dobneyresearch/PCNchip_with_leakyjug_learning/paper/main_stage2_v4.tex

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

\newcommand{\W}{\bm W}
\newcommand{\x}{\bm x}
\newcommand{\bdelta}{\bm\delta}
\newcommand{\E}{\bm E}

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

\hypertarget{sec:intro}{%
\section{Introduction}\label{sec:intro}}

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

This barrier is not unique to predictive coding; it is the central
difficulty of the whole analog-learning field, approached from several
directions. Analog in-memory training on non-volatile memory has reached
digital-equivalent accuracy \cite{ambrogio2018equivalent}, but it runs
conventional backpropagation --- transposed backward pass included ---
and depends on device-level symmetry of the weight update. Mixed-signal
spiking neural networks (SNNs) take the opposite premise: following the
biological observation that neurons \emph{integrate inputs as an analog
sum but communicate with spikes} \cite{cramer2022surrogate}, they
compute in analog and route events on an asynchronous digital fabric
\cite{chicca2014neuromorphic, benjamin2014neurogrid, moradi2018dynap}.
Their unsolved problem is training: device mismatch and low precision
distort weights and activations, so competitive accuracy is obtained
either by per-neuron calibration or by training the substrate \emph{in
the loop} with a host --- for example surrogate-gradient descent on
BrainScaleS-2, where ``learning self-corrects for device mismatch''
\cite{cramer2022surrogate}. On-chip local rules that avoid the host
\cite{rubino2023neuromorphic, davies2018loihi} remain Hebbian or
spike-timing based and do not reach backpropagation-grade credit
assignment on deep tasks. The common thread is that making a mismatched
analog substrate learn well has, so far, required either calibration, a
backward pass, or a host in the training loop.

Within predictive coding proper, Whittington and Bogacz
\cite{whittington2017approximation} establish the relationship to
backpropagation that motivates the approach, and Millidge et al.
\cite{millidge2022predictive} survey subsequent variants; recent work
has also reported synthesisable RTL realisations of PC networks
\cite{oh2026synthesizable}. What has been missing is an analog PC
design that trains in place \emph{without} reintroducing the backward
pass, the host, or the calibration step. This paper reports such an
architecture, together with its validation. We adopt three constraints
as design invariants rather than objectives, and do not relax them:

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

\begin{itemize}
\item
  An architecture in which the chip is an autonomous predictive-coding
  \emph{level}: it holds one copy of its weights \(\bm W\) and reads
  that copy three ways --- forward prediction, transpose relay, and
  error accumulation --- so that no weight ever leaves the die and every
  weight update is a local transaction (Sec. 3).
\item
  \emph{Transpose-at-source}: computing \(\bm W^{\!\top}\bm\delta\) on
  the chip that owns \(\bm W\), which eliminates the remote weight copy
  together with its coherence traffic and its synchronisation barrier,
  and reduces the router to summation and division (Secs. 3, 5).
\item
  A sigma--delta weight update in the error store \(\bm E\) (the
  \emph{leaky jug}), realised as a leaking capacitor and a shared
  comparator. The modulator is a standard structure; the contribution is
  its use as the weight-update path and the training-specific
  consequences of its bounded quantisation error --- why a learning rate
  of \(0.019\) weight LSB can drive an 8-bit analog cell with no
  per-synapse digital accumulator, why the comparator's decisions may be
  wrong at a substantial rate without corrupting learning, and why
  device mismatch acts only as a benign per-synapse learning-rate spread
  (Secs. 4, 6).
\item
  Validation on EMNIST letters showing the forwards-only rule matches
  backpropagation on the same topology, survives a bit-faithful hardware
  model and hostile device mismatch, with reported negative results
  (Secs. 6, 7), and an explicit positioning against NVM-based and
  spiking analog designs (Sec. 8).
\end{itemize}

\hypertarget{sec:pc}{%
\section{Predictive coding and the analog-neuromorphic
context}\label{sec:pc}}

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

Predictive coding models perception as inference in a hierarchical
generative model: each level emits a prediction of the level below and
retains the discrepancy as an error, and both representations and
weights are adjusted to reduce it
\cite{rao1999predictive, bogacz2017tutorial}. Its defining structural
commitment, and the one we build on, is that representation and error
are carried by \emph{separate} populations interacting only locally, one
level apart. We refer to this as the \(\bm W\&\bm E\) organisation:
activations are propagated forward through the weights \(\bm W\), errors
are accumulated in a separate store \(\bm E\), and when \(\bm E\)
crosses a threshold the corresponding weight in \(\bm W\) is adjusted.
Two properties make this a serious hardware substrate rather than a
biological analogy. It is \emph{locally computable} --- every quantity a
synapse needs is present at that synapse, so an update can be performed
in place rather than by a global gather --- and it has a
\emph{defensible relation to backpropagation}: a PC network with local
Hebbian plasticity computes updates that converge to those of
backpropagation when the output error is small relative to other
activity \cite{whittington2017approximation}. Although we started by
testing the W+E architecture with contrastive Hebbian learning, the
scheme we describe learns by approximating the backpropagation gradient
due to challenges making CHL work as a hardware solution.

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

\hypertarget{sec:arch}{%
\section{Architecture}\label{sec:arch}}

\hypertarget{design-principles}{%
\subsection{Design principles}\label{design-principles}}

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

\hypertarget{the-substrate-and-its-granularity-in-hardware}{%
\subsection{The substrate and its granularity in
hardware}\label{the-substrate-and-its-granularity-in-hardware}}

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

\hypertarget{sec:three}{%
\subsection{One weight memory, three consumers}\label{sec:three}}

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

\begin{enumerate}
\def\labelenumi{\arabic{enumi}.}
\item
  \textbf{Forward prediction (\(\bm W\)).} The code is mapped through a
  pre-distortion look-up table to the weight DAC and the analog array
  multiplies the incoming activation. This is the in-memory forward
  pass.
\item
  \textbf{Backward relay (\(\bm W^{\!\top}\)).} The same codes are read
  by a small digital engine that computes \(\bm W^{\!\top}\bm\delta\)
  for the incoming error and emits the result as a partial sum. This
  digital engine could be substituted by a cross-array read as analog
  (see below).
\item
  \textbf{Error accumulation (\(\bm E\)).} The incoming error, scaled by
  the locally latched forward activity, is injected onto a per-synapse
  capacitor; a threshold crossing writes a single \(\pm1\) step back to
  the SRAM.
\end{enumerate}

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

\hypertarget{sec:transpose}{%
\subsection{Transpose-at-source}\label{sec:transpose}}

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

That the transpose is digital is not a concession but the design's
premise. The analog array exists for \emph{inference}, where the forward
MAC sets the power and area budget; learning is a training-time
addition. Computing \(\bm W^{\!\top}\bm\delta\) digitally --- only
during training, at 6-bit precision, on one engine time-multiplexed
across the four cells --- adds a small, amortised cost that never
touches the inference path, and in exchange keeps the analog array
strictly one-way. The question this paper answers is therefore not
\emph{analog versus digital learning} but whether an analog inference
substrate can be made to learn in place without a reverse analog
channel, a host, or a clock. Energy and area are not quantified here:
this is a pre-silicon study of the learning mechanism and its accuracy,
and a power comparison awaits the physical design.

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

\hypertarget{sec:network}{%
\subsection{The network}\label{sec:network}}

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

\hypertarget{sec:theory}{%
\section{Formulation}\label{sec:theory}}

\hypertarget{forward-and-error-recursion}{%
\subsection{Forward and error
recursion}\label{forward-and-error-recursion}}

Write \(\bm x_0\) for the input feature vector and, for layers
\(\ell = 1,\dots,L\),
\begin{equation}
\bm a_\ell = \W_\ell \x_{\ell-1}, \qquad \x_\ell = \varphi(\bm a_\ell),
\end{equation}
with \(\varphi\) a leaky rectifier (\(\varphi(u) = u\) for \(u \ge 0\),
\(\alpha u\) otherwise, \(\alpha = 0.1\)). Each \(\bm W_\ell\) is
block-structured by the chip factoring of Sec. 3: a chip owns a set of
\(16\times16\) blocks and no block spans chips. A digital read-out
\(\bm s = \bm W_f \bm x_L + \bm b_f\) produces class scores, and the
output error for label \(y\) is
\begin{equation}
\bm e = \mathrm{onehot}(y) - \hat{\bm p},
\end{equation} \(\hat{\bm p}\) being the
read-out's class estimate. One further quantity is read from the same
scores: a scalar \emph{happiness} \(h\), the read-out's margin quantised
to a few levels (\(0\)--\(7\)), large only when a sample is
misclassified or is correct by a thin margin and zero when it is
comfortably correct. It carries no per-unit information --- one number
per sample --- and is broadcast to scale the update severity (Sec. 4.3);
pinning it to a constant recovers a fixed learning rate. The error is
then transported by the standard recursion, evaluated \emph{once} per
sample --- there is no relaxation phase, which is how C2 is discharged:
\begin{align}
\bdelta_L &= \mathcal{Q}\!\left[\,\mathcal{A}_L\!\left((\W_f^{\!\top}\bm e)\odot\varphi'(\bm a_L)\right)\right],\label{eq:dL}\\
\bdelta_{\ell-1} &= \mathcal{Q}\!\left[\,\mathcal{A}_{\ell-1}\!\left((\W_\ell^{\!\top}\bdelta_\ell)\odot\varphi'(\bm a_{\ell-1})\right)\right].\label{eq:drec}
\end{align} Equation \eqref{eq:drec} is exactly backpropagation's recursion; the
architectural content is \emph{where} each factor is evaluated. The
product \(\bm W_\ell^{\!\top}\bm\delta_\ell\) is computed on the chip
that owns \(\bm W_\ell\), from its own SRAM; the Jacobian factor
\(\varphi'(\bm a_{\ell-1})\) is a sign test on a locally latched
activation; and the sum over the chips contributing to a destination is
the router's gather. No unit needs a weight it does not own.

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

\hypertarget{sec:jug}{%
\subsection{The leaky jug as a sigma--delta modulator}\label{sec:jug}}

The alternative is to buy resolution with \emph{time}. The error store
is a capacitor \(C_e\) that is never reset. It leaks; incoming error
tops it up; and when it crosses a threshold \(\theta\) the synapse
\emph{fires}: the weight code moves by one LSB and \(\theta\) is
\emph{subtracted} from the capacitor, retaining the residue (Fig.~\ref{fig:jug}).
For one synapse, per sweep \(t\), \begin{equation}
E_t = \lambda E_{t-1} + g_t, \qquad
s_t = \operatorname{sign}(E_t)\,\mathbf{1}\!\left[|E_t| \ge \theta\right], \qquad
W_t = W_{t-1} + s_t, \qquad
E_t \leftarrow E_t - s_t\theta .
\label{eq:jug}
\end{equation}

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

Take \(\lambda = 1\) and sum \eqref{eq:jug} over \(T\) sweeps. Whatever the
comparator decides, the update to \(E\) and the update to \(W\) are the
\emph{same} event, so the identity
\begin{equation}
\theta \sum_{t=1}^{T} s_t \;=\; \sum_{t=1}^{T} g_t \;-\; E_T
\label{eq:invariant}
\end{equation} holds exactly. The left side is \(\theta\) times
the total motion of the weight code; the first term on the right is the
total accumulated gradient. Since the subtraction removes exactly
\(\theta\) whenever the level reaches \(\theta\), and the injection per
sweep is small, \(|E_T|\) remains bounded by the capacitor's clamp
\(E_{\max}\). Therefore
\begin{equation}
\Bigl| \sum_{t=1}^{T} s_t - \frac{1}{\theta}\sum_{t=1}^{T} g_t \Bigr|
\;\le\; \frac{E_{\max}}{\theta},
\label{eq:bound}
\end{equation} where \(\sum_t s_t\) is the total motion of the
weight code in LSB --- a bound \emph{independent of \(T\)}. The weight
tracks the accumulated gradient scaled by \(1/\theta\), with an error
that does not grow with the length of training. This is the sigma--delta
property, and it is the mathematical content of the design: rounding
each update discards a fixed fraction of every step (here, all of it);
the jug defers steps but discards none.

Three corollaries follow directly, and each is confirmed in Sec. 6.

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

\emph{The comparator may be wrong.} Identity \eqref{eq:invariant} does not assume \(s_t\)
is correct. A wrong-signed fire moves the weight the wrong way
\emph{and} pushes the residue further from zero by \(\theta\), which
makes the next fire more likely and of the correct sign; the charge is
conserved and the error is repaid. What must be accurate is the
\emph{charge on the capacitor}, not any decision made about it. This
inverts the usual analog design burden: the comparator, normally a
precision component, becomes the loose one.

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

\hypertarget{one-tight-specification-and-only-one.}{%
\paragraph{One tight specification, and only
one.}\label{one-tight-specification-and-only-one.}}

The mechanism asks for analog accuracy in exactly one place: the residue
subtraction must remove a fixed charge \(\theta\) independent of the
capacitor's voltage, which is realised as a current-steered pulse
\(Q = It\). Identity \eqref{eq:invariant} is the reason it is the \emph{only} tight
specification --- because charge is conserved across the fire event,
everything downstream of it, the comparator decision included, is
permitted to be loose.

\hypertarget{the-leak-is-momentum.}{%
\paragraph{The leak is momentum.}\label{the-leak-is-momentum.}}

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

\hypertarget{the-comparator-is-shared-and-swept-not-per-synapse.}{%
\paragraph{The comparator is shared and swept, not
per-synapse.}\label{the-comparator-is-shared-and-swept-not-per-synapse.}}

A single comparator walks the array, so a synapse is tested once per
sweep and can fire at most once per sweep. This is a design commitment
rather than an approximation: it is \(256\times\) cheaper per cell, and
the sweep period acts as a refractory interval. A per-synapse comparator
would allow repeated firing on a single crossing; we measure this to be
unstable (Sec. 6). A synapse holding \(3\theta\) therefore emits a train
of three single fires on successive sweeps rather than one triple fire
--- the boost is delayed, never discarded. Clamping the capacitor harder
would be the wrong rate limiter, as it destroys charge that \eqref{eq:invariant}
requires.

\hypertarget{the-error-is-out-of-the-forward-path.}{%
\paragraph{The error is out of the forward
path.}\label{the-error-is-out-of-the-forward-path.}}

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

\hypertarget{sec:interconnect}{%
\section{Interconnect and asynchrony}\label{sec:interconnect}}

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

\hypertarget{sec:results}{%
\section{Evaluation}\label{sec:results}}

\hypertarget{method}{%
\subsection{Method}\label{method}}

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

\hypertarget{robustness}{%
\subsection{Robustness}\label{robustness}}

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

Two transistor-level results support the design's central claims, and
both concern the one place the mechanism is demanding. First, the
residue subtraction of \eqref{eq:jug} is realised as a current-steered charge
pulse, \(Q = It\), and is verified in Sky130A SPICE to remove a
\emph{fixed} charge independent of the capacitor's voltage. This is the
design's single tight analog specification, and identity \eqref{eq:invariant} is the
reason it is the only one: because charge is conserved across the fire
event, everything downstream of it is permitted to be loose. Second, the
component the theory allows to be loose --- the comparator --- is, in
silicon, comfortably precise: a transistor-level window comparator
settles to within \(0.75\) mV of each threshold, with a dead zone of
\(\approx 0.2\,\mu\)V, in \(2.5\) ns. The robustness measurement above
shows the sigma--delta absorbs \emph{wrong} comparator decisions at the
level of tens of percent; the physical comparator errs at the level of
microvolts. The tolerance the theory demands and the margin the physics
delivers are therefore separated by orders of magnitude. (A bit-faithful
RTL realisation independently reproduces the transpose within \(\pm1\)
LSB and every residue of \eqref{eq:jug} within \(2\,\mu\)V of the model; netlists
and test benches are in the repository.)

\hypertarget{sec:history}{%
\section{Design history and negative results}\label{sec:history}}

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

\hypertarget{on-method.}{%
\paragraph{On method.}\label{on-method.}}

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

\hypertarget{sec:related}{%
\section{Related work and positioning}\label{sec:related}}

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

\hypertarget{sec:conclusion}{%
\section{Limitations and conclusion}\label{sec:conclusion}}

\hypertarget{limitations.}{%
\paragraph{Limitations.}\label{limitations.}}

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

\hypertarget{conclusion.}{%
\paragraph{Conclusion.}\label{conclusion.}}

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

\hypertarget{acknowledgements}{%
\section*{Acknowledgements}\label{acknowledgements}}
\addcontentsline{toc}{section}{Acknowledgements}

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

\bibliographystyle{IEEEtran}
\bibliography{refs}
\end{document}
