dobneyresearch/PCNchip_with_leakyjug_learning/paper/main_stage2_v4_post_3.md

<!-- ============================================================================
EDITABLE MARKDOWN TWIN — main_stage2_v4_postbogacz_1  (reorg of v4, 2026-08-20)

POST-BOGACZ REORGANISATION. Same content, tone, and depth as v4; the changes are
structural + clarity only, addressing R. Bogacz's review:
  * the ALGORITHM (the learning rule, Sec. 3) is now stated BEFORE the hardware
    realisation (Sec. 4), and the two are kept separate (his main point);
  * every acronym/concept is defined on first use + a short Terms box;
  * the abstract no longer opens with undefined jargon (LSB removed).
No new results; the constraint-ledger idea and the new EMNIST numbers are NOT here
(the latter are a Paper-3 point).

Build to PDF:  python3 build_postbogacz.py  then pdflatex/bibtex/pdflatex x2.
The .tex it emits (main_stage2_v4_postbogacz_1.tex) takes equations/figures/preamble
verbatim from main_stage2_v3.tex, so numbered-equation references stay correct.

Edit prose freely here and hand back; I port edits into the .tex and rebuild.
FIGURES are TikZ and cannot round-trip; their captions live in v3.tex / the build
script, so edits to the figure blockquotes below are cosmetic for the .md only.
============================================================================ -->

---
abstract: |
  Analog architectures for predictive-coding networks benefit from in-memory computation which removes the weight-movement cost that dominates digital neural inference, but currently there are no established mechanisms for *supervised training in place* that avoid a backward pass, per-device calibration, or a host in the loop. We present a hardware-focused analog predictive-coding architecture that trains in place under three invariants --- signal paths are one way (*forwards-only*), no per-device calibration (*robust*), and no global clock (*asynchronous*) --- and show they cost essentially no accuracy. This is accomplished by a separated weights and error design, computing each weight matrix's transpose on the chip that owns it and a sigma--delta weight update via a *leaky-jug* error accumulator and a threshold comparator, whose cumulative quantisation error is bounded independently of the number of updates (the first-order sigma--delta property). In this design a per-update step far below one weight quantisation step drives a coarse analog cell with no per-synapse digital accumulator, which means the comparator may be wrong at a substantial rate without corrupting learning, and device mismatch appears only as a benign per-synapse spread of the learning rate. On EMNIST letters with a 48-chip topology the forwards-only rule reaches $82.50\%$ against a full-backpropagation ceiling of $82.85\%$ on identical topology, and a bit-faithful hardware model stays within the run-to-run noise band of its floating-point ceiling. All results are pre-silicon.
author:
- Saul Dobney[^1]
bibliography:
- refs.bib
date: 2026
title: |
  **A Forwards-Only, Asynchronous Analog Architecture for\
  Predictive-Coding Networks: Local Transpose and\
  Sigma--Delta Weight Update for On-Die Supervised Learning**
---

# Introduction {#sec:intro}

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

This barrier is not unique to predictive coding; it is a difficulty for the whole analog-learning field, approached from several directions. Analog in-memory training on non-volatile memory (NVM) has reached digital-equivalent accuracy [@ambrogio2018equivalent], but it runs conventional backpropagation --- transposed backward pass included --- and depends on device-level symmetry of the weight update. Mixed-signal spiking neural networks (SNNs) take the opposite premise: following the biological observation that neurons *integrate inputs as an analog sum but communicate with spikes* [@cramer2022surrogate], they compute in analog and route events on an asynchronous digital fabric [@chicca2014neuromorphic; @benjamin2014neurogrid; @moradi2018dynap]. Their unsolved problem is training: device mismatch and low precision distort weights and activations, so competitive accuracy is obtained either by per-neuron calibration or by training the substrate *in the loop* with a host --- for example surrogate-gradient descent on BrainScaleS-2, where "learning self-corrects for device mismatch" [@cramer2022surrogate]. On-chip local rules that avoid the host [@rubino2023neuromorphic; @davies2018loihi] remain Hebbian, or spike-timing based, and do not reach backpropagation-grade credit assignment on deep tasks. The common thread is that making a mismatched analog substrate learn well has, so far, required either calibration, a backward pass, or a host in the training loop.

Within predictive coding proper, Whittington and Bogacz [@whittington2017approximation] establish the relationship to backpropagation that motivates the approach, and Millidge et al. [@millidge2022predictive] survey subsequent variants; recent work has also reported synthesisable register-transfer-level (RTL) realisations of PC networks [@oh2026synthesizable]. What has been missing is an analog PC design that trains in place *without* reintroducing the backward pass, the host, or the calibration step.

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

Two further principles are design commitments rather than hard invariants: the design is **modular** --- the network topology is a soft, reconfigurable property of the inter-chip router rather than fixed wiring --- and **hardware-feasible** --- every element is chosen to be synthesisable or fabricable in an open $130$ nm process (Sky130A). We began by testing the separated-weights architecture with contrastive Hebbian learning (CHL), the canonical predictive-coding rule, but found it too fragile under these constraints (Sec. 2); the rule reported here instead approximates the backpropagation gradient while respecting them.

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

## Terms and notation

For readers coming from either side of this work, the recurring terms are collected here.

- **PC** --- predictive coding. **CHL** --- contrastive Hebbian learning, the canonical PC weight rule. **$\bm W\&\bm E$** --- the design's *separated* weight store $\bm W$ and error store $\bm E$.
- **$\bm\delta$** --- a transported error signal; **$\bm W^{\!\top}$** --- the transpose (column-wise read) of a weight matrix, needed to route error to the previous layer.
- **Weight code / quantisation step** --- the analog weight is set by an 8-bit digital code; one code step ($1/64$ of the weight range here) is the smallest weight change, the analog analogue of a *least-significant bit* (LSB).
- **Leaky jug** --- the per-synapse error accumulator: a capacitor that integrates error, leaks slowly, and "fires" one weight code step when it crosses a threshold. Its formal reading is a first-order **sigma--delta** ($\Sigma\Delta$) modulator.
- **Hardware acronyms** (Sec. 4 onward): **OTA**, operational transconductance amplifier (the analog multiplier cell); **MAC**, multiply--accumulate; **SRAM**, static memory holding the weight codes; **DAC/ADC**, digital-to-analog / analog-to-digital converter; **SAR**, successive-approximation register (the ADC type); **AGC**, automatic gain control; **RTL**, register-transfer level (a synthesisable digital description); **SPICE**, the analog circuit simulator; **NVM**, non-volatile memory.

# Predictive coding and the analog-neuromorphic context {#sec:pc}

## The $\bm W$ & $\bm E$ principle

Predictive coding models perception as inference in a hierarchical generative model: each level emits a prediction of the level below and retains the discrepancy as an error, and both representations and weights are adjusted to reduce it [@rao1999predictive; @bogacz2017tutorial]. Its defining structural commitment, and the one we build on, is that representation and error are carried by *separate* populations interacting only locally, one level apart. We refer to this as the $\bm W\&\bm E$ organisation: activations are propagated forward through the weights $\bm W$, errors are accumulated in a separate store $\bm E$, and when $\bm E$ crosses a threshold the corresponding weight in $\bm W$ is adjusted. Two properties make this a serious hardware substrate rather than a biological analogy. It is *locally computable* --- every quantity a synapse needs is present at that synapse, so an update can be performed in place rather than by a global gather --- and it has a *defensible relation to backpropagation*: a PC network with local Hebbian plasticity computes updates that converge to those of backpropagation when the output error is small relative to other activity [@whittington2017approximation]. We began our research by testing the $\bm W\&\bm E$ architecture with contrastive Hebbian learning, but the scheme we describe instead learns by approximating the backpropagation gradient, because of the difficulties --- set out next --- of making CHL work as a hardware solution.

## Four obstacles to an analog realisation of CHL {#sec:pc-challenges}

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

#### C1: the framework is bidirectional.

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

#### C2: inference is iterative and clock-based.

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

#### C3: the update quantum is tiny.

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

#### C4: spiking is treated as the system, not a communication protocol.

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

# The learning rule {#sec:theory}

This section states the rule as an algorithm, independently of how it is built; the hardware realisation follows in Sec. 4. The rule uses ordinary backpropagation's credit assignment, evaluated *once* per sample and written to the weights through a threshold-accumulator instead of an arithmetic add. The approach of backprop with the threshold-accumulator was chosen to meet the constraints of a hardware-first design. Core to this is the separation of weights and the forwards path, from the 'errors' and the error propagation path, with a leaky-accumulator used as the mechanism for updating the weights in the learning phase. The same credit assignment as ordinary backpropagation is computed, but it is delivered through a forwards-only, hardware-robust design --- a quantised threshold write over small-matrix networks rather than the massive matrix multiplies of conventional backpropagation.

Structurally the rule is a loop with two separated stores, and it is worth seeing the whole of it before the algebra. The forward path carries a sample through the weights, input $\to \bm W_1 \to \bm W_2 \to \dots \to$ read-out, and the read-out forms a single output error $\bm\delta$ --- one vector, not a field of them. That error is then relayed layer by layer, *backward through the network but forward in signalling*: each layer computes $\bm W^{\!\top}\bm\delta$ from the weights it already holds, hands the result to the layer before it, and drops its own share into a local error store. The store is a leaky accumulator --- a *jug* --- that integrates what it receives and, only when it crosses a threshold, writes a single $\pm1$ code step into that layer's weights. There is no relaxation phase and no reverse analog pass: one forward sweep, one error relay, one conditional weight step per synapse (Fig. 0).

<!-- FIGURE 0 (fig:overview) — TO BE DRAWN in the .tex (TikZ). High-level dataflow:
     input -> W1 -> W2 -> digital read-out (forms delta); delta relayed as W2^T.delta into E2
     and W1^T.delta into E1, where E1,E2 are leaky jugs that write single-code updates back into
     W1,W2. Every link is mediated by the router. No analog signal flows in reverse.
     Caption comes from the build script; edit there for changes. -->

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

## Forward and error recursion

Write $\bm x_0$ for the input feature vector and, for layers $\ell = 1,\dots,L$, $$\bm a_\ell = \bm W_\ell \bm x_{\ell-1}, \qquad \bm x_\ell = \varphi(\bm a_\ell),$$ with $\varphi$ a leaky rectifier ($\varphi(u) = u$ for $u \ge 0$, $\alpha u$ otherwise, $\alpha = 0.1$). Each $\bm W_\ell$ is block-structured by the chip factoring of Sec. 4: a chip owns a set of $16\times16$ blocks and no block spans chips. A digital read-out $\bm s = \bm W_f \bm x_L + \bm b_f$ produces class scores, and the output error for label $y$ is $$\bm e = \mathrm{onehot}(y) - \hat{\bm p},$$ $\hat{\bm p}$ being the read-out's class estimate. One further quantity is read from the same scores: a scalar *happiness* $h$, the read-out's margin quantised to a few levels ($0$--$7$), large only when a sample is misclassified or is correct by a thin margin and zero when it is comfortably correct. It carries no per-unit information --- one number per sample --- and is broadcast to scale the update severity (Sec. 3.3); pinning it to a constant recovers a fixed learning rate. The error is then transported by the standard recursion, evaluated *once* per sample --- there is no relaxation phase, which is how C2 is discharged: $$\begin{aligned}
\bm\delta_L &= \mathcal{Q}\!\left[\,\mathcal{A}_L\!\left((\bm W_f^{\!\top}\bm e)\odot\varphi'(\bm a_L)\right)\right],\label{eq:dL}\\
\bm\delta_{\ell-1} &= \mathcal{Q}\!\left[\,\mathcal{A}_{\ell-1}\!\left((\bm W_\ell^{\!\top}\bm\delta_\ell)\odot\varphi'(\bm a_{\ell-1})\right)\right].\label{eq:drec}
\end{aligned}$$ Equation (4) is exactly backpropagation's recursion; the architectural content, developed in Sec. 4, is *where* each factor is evaluated. The product $\bm W_\ell^{\!\top}\bm\delta_\ell$ is a transpose of the layer's own weights; the Jacobian factor $\varphi'(\bm a_{\ell-1})$ is a sign test on that layer's forward activation; and the sum over the parts contributing to a destination is a plain addition. No unit needs a weight it does not own.

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

## The update, and why a naive one fails

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

## The leaky jug as a sigma--delta modulator {#sec:jug}

The alternative is to buy resolution with *time*. The error store is a value $E$ that is never reset. It leaks; incoming error tops it up; and when it crosses a threshold $\theta$ the synapse *fires*: the weight code moves by one step and $\theta$ is *subtracted* from the store, retaining the residue (Fig. 3). For one synapse, per sweep $t$, $$E_t = \lambda E_{t-1} + g_t, \qquad
s_t = \operatorname{sign}(E_t)\,\mathbf{1}\!\left[|E_t| \ge \theta\right], \qquad
W_t = W_{t-1} + s_t, \qquad
E_t \leftarrow E_t - s_t\theta .
\label{eq:jug}$$

<!-- FIGURE 3 (fig:jug) — drawn in TikZ in main_stage2_v3.tex; not representable in Markdown.
     Diagram — the leaky jug: a capacitor with +theta/-theta threshold lines, error flowing in at the top, a leak draining at the bottom right, and a fire arrow below.
     Caption comes from v3.tex; this blockquote is a placeholder for the .md reader only. -->

> **Figure 3 (fig:jug).** **The leaky jug.** Error accumulates in the store; it leaks, which supplies momentum; a threshold crossing fires one weight code step and subtracts $\theta$, retaining the residue. The retained residue is what makes the mechanism a sigma--delta modulator rather than a lossy quantiser.

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

#### Bounded, non-accumulating quantisation error.

Take $\lambda = 1$ and sum (5) over $T$ sweeps. Whatever the comparison decides, the update to $E$ and the update to $W$ are the *same* event, so the identity $$\theta \sum_{t=1}^{T} s_t \;=\; \sum_{t=1}^{T} g_t \;-\; E_T
\label{eq:invariant}$$ holds exactly. The left side is $\theta$ times the total motion of the weight code; the first term on the right is the total accumulated gradient. Since the subtraction removes exactly $\theta$ whenever the level reaches $\theta$, and the injection per sweep is small, $|E_T|$ remains bounded by the store's clamp $E_{\max}$. Therefore $$\Bigl| \sum_{t=1}^{T} s_t - \frac{1}{\theta}\sum_{t=1}^{T} g_t \Bigr|
\;\le\; \frac{E_{\max}}{\theta},
\label{eq:bound}$$ where $\sum_t s_t$ is the total motion of the weight code --- a bound *independent of $T$*. The weight tracks the accumulated gradient scaled by $1/\theta$, with an error that does not grow with the length of training. This is the sigma--delta property, and it is the mathematical content of the design: rounding each update discards a fixed fraction of every step (here, all of it); the jug defers steps but discards none.

Three corollaries follow directly, and each is confirmed in Sec. 6.

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

*The comparison may be wrong.* Identity (6) does not assume $s_t$ is correct. A wrong-signed fire moves the weight the wrong way *and* pushes the residue further from zero by $\theta$, which makes the next fire more likely and of the correct sign; the accumulated quantity is conserved and the error is repaid. What must be accurate is the *stored quantity*, not any decision made about it. This inverts the usual analog design burden: the threshold comparison, normally a precision operation, becomes the loose one.

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

#### The leak is momentum.

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

# Hardware realisation {#sec:arch}

Having fixed the rule, we now describe how each of its computations is carried out in silicon. The design is a mixed analog--digital one that allows flexible topologies: the core compute is analog, done with capacitance and transconductance, but the weight *values* are held digitally in SRAM to protect them from decay on a capacitor. We describe it from the unit that matters most --- the chip and its single weight memory --- outward to the network.

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

## The substrate and its granularity

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

#### The weight cell is non-linear, and is linearised by pre-distortion.

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

## One weight memory, three consumers {#sec:three}

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

<!-- FIGURE 1 (fig:chip) — drawn in TikZ in main_stage2_v3.tex; not representable in Markdown.
     Block diagram — the chip: W-SRAM at the centre, feeding (a) LUT -> weight DAC -> analog MAC -> ADC across the top, (b) the transpose engine reading the same SRAM, (c) the leaky jug writing +/-1 codes back into it.
     Caption comes from v3.tex; this blockquote is a placeholder for the .md reader only. -->

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

3.  **Error accumulation ($\bm E$).** The incoming error, scaled by the locally latched forward activity, forms the per-synapse increment $g_t$ of (5); a threshold crossing writes a single $\pm1$ step back to the SRAM.

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

## Transpose-at-source {#sec:transpose}

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

## The error store in hardware {#sec:jughw}

The rule's update path (5)--(7) is realised by a leaking capacitor $C_e$ and a shared comparator. The mathematics asked for three things of this circuit, and each turns a normally-tight analog requirement into a loose one.

*One tight specification, and only one.* The mechanism asks for analog accuracy in exactly one place: the residue subtraction must remove a fixed quantity $\theta$ independent of the capacitor's voltage, realised as a current-steered charge pulse $Q = It$. Identity (6) is the reason it is the *only* tight specification --- because the stored quantity is conserved across the fire event, everything downstream of it, the comparator decision included, is permitted to be loose.

*The comparator is shared and swept, not per-synapse.* A single comparator walks the array, so a synapse is tested once per sweep and can fire at most once per sweep. This is a design commitment rather than an approximation: it is $256\times$ cheaper per cell, and the sweep period acts as a refractory interval. A per-synapse comparator would allow repeated firing on a single crossing; we measure this to be unstable (Sec. 6). A synapse holding $3\theta$ therefore emits a train of three single fires on successive sweeps rather than one triple fire --- the boost is delayed, never discarded. Clamping the capacitor harder would be the wrong rate limiter, as it destroys the stored quantity that (6) requires.

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

## The network {#sec:network}

<!-- FIGURE 2 (fig:net) — drawn in TikZ in main_stage2_v3.tex; not representable in Markdown.
     Block diagram — the network: three L1 chips -> router (gather: sum then divide by fan-in) -> L2 chip, with the backward delta/partials shown dashed on the SAME links.
     Caption comes from v3.tex; this blockquote is a placeholder for the .md reader only. -->

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

# Interconnect and asynchrony {#sec:interconnect}

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

# Evaluation {#sec:results}

## Method

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

## Does the forwards-only rule learn?

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

: Learning rule, float rig, EMNIST letters, BIG topology.

## Does the rule survive the hardware arithmetic?

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

## Robustness

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

## Robustness in the face of asynchronicity

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

## Does the analog physics permit it? (SPICE)

Two transistor-level results support the design's central claims, and both concern the one place the mechanism is demanding. First, the residue subtraction of (5) is realised as a current-steered charge pulse, $Q = It$, and is verified in Sky130A SPICE to remove a *fixed* charge independent of the capacitor's voltage. This is the design's single tight analog specification, and identity (6) is the reason it is the only one: because charge is conserved across the fire event, everything downstream of it is permitted to be loose. Second, the component the theory allows to be loose --- the comparator --- is, in silicon, comfortably precise: a transistor-level window comparator settles to within $0.75$ mV of each threshold, with a dead zone of $\approx 0.2\,\mu$V, in $2.5$ ns. The robustness measurement above shows the sigma--delta absorbs *wrong* comparator decisions at the level of tens of percent; the physical comparator errs at the level of microvolts. The tolerance the theory demands and the margin the physics delivers are therefore separated by orders of magnitude. (A bit-faithful RTL realisation independently reproduces the transpose within $\pm1$ weight code and every residue of (5) within $2\,\mu$V of the model; netlists and test benches are in the repository.)

# Design history and negative results {#sec:history}

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

#### Bidirectional schemes were abandoned first.

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

#### A long plateau under a $\bm W{+}\bm E$ decomposition.

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

#### On method.

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

# Related work and positioning {#sec:related}

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

#### Analog in-memory training on non-volatile memory.

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

#### Mixed-signal spiking neuromorphic systems.

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

#### Predictive coding and feedback alignment.

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

# Separability, modularity, and scale {#sec:scale}

One decision underlies every property claimed above, and it is clearest stated here, once the pieces are on the table. The decision is to **separate the weights from the errors** --- to treat the forward computation and the learning signal as two stores on two paths ($\bm W\&\bm E$), rather than as one object updated in place by a backward pass coupled to the forward one. The three invariants of the introduction, and the modularity that lets the fabric grow, are consequences of that separation rather than independent achievements.

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

Read forwards, the chain is *separation* $\to$ *self-containment* $\to$ *modularity* $\to$ *scale*, and it is why the invariants cost so little accuracy rather than so much. Forwards-only is what permits the single weight copy; robustness is what lets a coarse, mismatch-ridden cell be replicated without per-die calibration; asynchrony is what lets the replicas run without a shared clock. They are not three separate constraints that happened to be satisfiable together, but three aspects of the one separation --- and the accuracy figures of the evaluation are the measurement that paying for it costs essentially nothing.

# Limitations and conclusion {#sec:conclusion}

#### Limitations.

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

#### Conclusion.

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

# Acknowledgements {#acknowledgements .unnumbered}

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
