dobneyresearch/PCNchip_with_leakyjug_learning/Sky130A_16x16_4cell_jug/rtl/tb_pcn_wb_regs_4cell_emx.v

`timescale 1ns/1ps
// tb_pcn_wb_regs_4cell_emx.v — WB register read/write tests (EMX registers only)
//
// Exercises the new EMX registers added at 0x74–0x8C:
//   T1  TRAINING_MODE write/read
//   T2  LR_CFG (bh + lr_shift) write/read
//   T3  DELTA_IDX write sets inject_cell; DELTA_DATA writes delta_buf
//   T4  DELTA_DATA readback via DELTA_IDX
//   T5  EMX_CTRL[0] produces start_e_update pulse
//   T6  EMX_CTRL[1] produces start_absorb pulse
//   T7  EMX_CTRL[2] produces start_save pulse
//   T8  EMX_STATUS reflects busy inputs
//   T9  REFRESH_EN write/read
//   T10 Inherited register (CTRL/STATUS at 0x08/0x0C) still works

module tb_pcn_wb_regs_4cell_emx;
    localparam N_ROWS  = 16;
    localparam N_CELLS = 4;

    reg  clk, rst_n;
    reg  [31:0] wb_addr, wb_wdat;
    reg  [3:0]  wb_sel;
    reg         wb_we, wb_cyc, wb_stb;
    wire [31:0] wb_rdat;
    wire        wb_ack;

    // EMX status inputs (drive from testbench)
    reg  e_update_busy, absorb_busy, save_busy;
    // IRQ inputs
    reg  router_busy, irq_frame_done;
    reg  [3:0] status_in;
    reg  [N_ROWS-1:0] ierr_in;
    reg  [7:0] sram_rdata_in, act_rdata_in;

    // Observed EMX outputs
    wire        training_mode;
    wire [2:0]  bh;
    wire [5:0]  lr_shift;   // ⚠ 6 bits — was declared [4:0] here, which SILENTLY TRUNCATED the
                            // DUT's output and hid an LR_CFG bit-aliasing bug. Keep it matched.
    wire [1:0]  inject_cell;
    wire [N_CELLS*N_ROWS*8-1:0] delta_flat;
    wire        start_e_update, start_absorb, start_save;
    wire        refresh_en;

    // Other outputs (not checked in this test)
    wire [7:0]  weight_data;
    wire [15:0] cell_addr;
    wire [5:0]  ctrl;
    wire [N_ROWS-1:0] hebb_mask, hebb_row_mask;
    wire [15:0] hebb_pw;
    wire [7:0]  sram_wdata;
    wire        sram_we, start_load, load_all, rst_weights, start_temporal;
    wire [3:0]  n_virt_layers;
    wire        start_adc_sweep, inp_dac_wb_we, act_wb_we;
    wire [7:0]  inp_dac_wb_data, act_wb_wdata;
    wire [15:0] inp_dac_wb_addr;
    wire        topo_mode, start_frame;
    wire [24:0] loop_mask;
    wire [4:0]  input_cell_mask, output_cell_mask;
    wire [15:0] dispatch_pw;
    wire [7:0]  my_chip_id, spi_clk_div;
    wire [31:0] next_hop_chip_id, peer_next_hop_chip_id;
    wire [15:0] dest_cell_id_reg, peer_dest_cell_id_reg;
    wire [N_CELLS-1:0] peer_output_mask;

    integer pass_cnt, fail_cnt;

    pcn_wb_regs_4cell_emx #(.N_ROWS(N_ROWS), .N_CELLS(N_CELLS)) dut (
        .clk(clk), .rst_n(rst_n),
        .wb_addr_i(wb_addr), .wb_dat_i(wb_wdat), .wb_sel_i(wb_sel),
        .wb_we_i(wb_we), .wb_cyc_i(wb_cyc), .wb_stb_i(wb_stb),
        .wb_dat_o(wb_rdat), .wb_ack_o(wb_ack),
        .weight_data(weight_data), .cell_addr(cell_addr), .ctrl(ctrl),
        .hebb_mask(hebb_mask), .hebb_pw(hebb_pw), .status(status_in),
        .sram_wdata(sram_wdata), .sram_we(sram_we), .sram_rdata(sram_rdata_in),
        .start_load(start_load), .load_all(load_all), .rst_weights(rst_weights),
        .start_temporal(start_temporal), .n_virt_layers(n_virt_layers),
        .hebb_row_mask(hebb_row_mask), .ierr_dig_i(ierr_in),
        .start_adc_sweep(start_adc_sweep),
        .inp_dac_wb_data(inp_dac_wb_data), .inp_dac_wb_addr(inp_dac_wb_addr),
        .inp_dac_wb_we(inp_dac_wb_we), .act_rdata_wb_i(act_rdata_in),
        .act_wb_wdata(act_wb_wdata), .act_wb_we(act_wb_we),
        .topo_mode(topo_mode), .loop_mask(loop_mask),
        .input_cell_mask(input_cell_mask), .output_cell_mask(output_cell_mask),
        .dispatch_pw(dispatch_pw), .my_chip_id(my_chip_id), .spi_clk_div(spi_clk_div),
        .start_frame(start_frame), .router_busy(router_busy),
        .irq_frame_done(irq_frame_done),
        .next_hop_chip_id(next_hop_chip_id), .dest_cell_id_reg(dest_cell_id_reg),
        .peer_output_mask(peer_output_mask),
        .peer_next_hop_chip_id(peer_next_hop_chip_id),
        .peer_dest_cell_id_reg(peer_dest_cell_id_reg),
        .training_mode(training_mode), .bh(bh), .lr_shift(lr_shift),
        .inject_cell(inject_cell), .delta_flat(delta_flat),
        .start_e_update(start_e_update), .start_absorb(start_absorb),
        .start_save(start_save), .refresh_en(refresh_en),
        .e_update_busy(e_update_busy), .absorb_busy(absorb_busy), .save_busy(save_busy),
        .routing_matrix_hebb_i(16'h0), .routing_matrix_hebb_we(1'b0)
    );

    initial clk = 0;
    always #5 clk = ~clk;

    `define PASS(msg) begin $display("  PASS %s", msg); pass_cnt=pass_cnt+1; end
    `define FAIL(msg) begin $display("  FAIL %s", msg); fail_cnt=fail_cnt+1; end

    // WB write helper
    task wb_write;
        input [31:0] addr;
        input [31:0] data;
        begin
            @(negedge clk);
            wb_addr=addr; wb_wdat=data; wb_sel=4'hF;
            wb_we=1; wb_cyc=1; wb_stb=1;
            @(posedge clk); #1;
            wb_we=0; wb_cyc=0; wb_stb=0;
        end
    endtask

    // WB read helper (result in wb_rdat)
    task wb_read;
        input [31:0] addr;
        begin
            @(negedge clk);
            wb_addr=addr; wb_sel=4'hF;
            wb_we=0; wb_cyc=1; wb_stb=1;
            @(posedge clk); #1;
            wb_cyc=0; wb_stb=0;
        end
    endtask

    integer i;

    initial begin : tb
        pass_cnt = 0; fail_cnt = 0;
        wb_we=0; wb_cyc=0; wb_stb=0;
        wb_addr=0; wb_wdat=0; wb_sel=4'hF;
        e_update_busy=0; absorb_busy=0; save_busy=0;
        router_busy=0; irq_frame_done=0;
        status_in=4'h1; ierr_in=0; sram_rdata_in=0; act_rdata_in=0;

        rst_n=0; repeat(2) @(posedge clk); #1;
        rst_n=1; @(posedge clk); #1;
        $display("\n=== pcn_wb_regs_4cell_emx tests ===");

        // ── T1: TRAINING_MODE ─────────────────────────────────────────────
        wb_write(32'h74, 32'h1);   // set TRAINING_MODE=1
        @(posedge clk); #1;
        if (training_mode == 1'b1) `PASS("T1-write: training_mode=1")
        else `FAIL("T1-write: training_mode not set")
        wb_read(32'h74);
        if (wb_rdat[0] == 1'b1) `PASS("T1-read: training_mode readback=1")
        else `FAIL("T1-read: training_mode readback wrong")
        wb_write(32'h74, 32'h0);   // clear
        @(posedge clk); #1;
        if (training_mode == 1'b0) `PASS("T1-clear: training_mode=0")
        else `FAIL("T1-clear: training_mode not cleared")

        // ── T2: LR_CFG (bh + lr_shift) ───────────────────────────────────
        // Layout is 9-bit, NOT byte-packed: [8:6]=BH[2:0], [5:0]=LR_SHIFT[5:0].
        // ★ lr_shift=47 is chosen deliberately because bit 5 is SET: under the old
        //   packing (bh<=[7:5], lr_shift<=[5:0]) bit 5 aliased into BOTH fields, so this
        //   vector fails there and the test discriminates.
        wb_write(32'h78, (32'd5 << 6) | 32'd47);   // bh=5=3'b101, lr_shift=47=6'b101111 → 0x16F
        @(posedge clk); #1;
        if (bh == 3'd5 && lr_shift == 6'd47) `PASS("T2-write: bh=5, lr_shift=47 (bit5 set)")
        else begin
            $display("  FAIL T2-write: bh=%0d (exp 5) lr_shift=%0d (exp 47)", bh, lr_shift);
            fail_cnt = fail_cnt + 1;
        end
        wb_read(32'h78);
        if (wb_rdat[8:0] == 9'h16F) `PASS("T2-read: LR_CFG readback correct")
        else begin
            $display("  FAIL T2-read: LR_CFG=%03h (exp 16F)", wb_rdat[8:0]);
            fail_cnt = fail_cnt + 1;
        end

        // ── T3: DELTA_IDX + DELTA_DATA writes ────────────────────────────
        // Write cell=1, row=3 → inject_cell should be 1
        wb_write(32'h7C, 32'h13);  // {cell=1, row=3} = 6'b01_0011 = 8'h13
        @(posedge clk); #1;
        if (inject_cell == 2'd1) `PASS("T3-cell: inject_cell=1 from DELTA_IDX")
        else begin
            $display("  FAIL T3-cell: inject_cell=%0d", inject_cell);
            fail_cnt = fail_cnt + 1;
        end
        wb_write(32'h80, 32'hAB);  // write delta=0xAB to cell=1, row=3
        @(posedge clk); #1;
        // delta_flat[(1*16+3)*8 +: 8] should be 0xAB
        if (delta_flat[(1*N_ROWS+3)*8 +: 8] == 8'hAB)
            `PASS("T3-data: delta_flat[cell=1,row=3]=0xAB")
        else begin
            $display("  FAIL T3-data: delta_flat[1,3]=%02h", delta_flat[(1*N_ROWS+3)*8+:8]);
            fail_cnt = fail_cnt + 1;
        end

        // ── T4: DELTA_DATA readback ───────────────────────────────────────
        wb_read(32'h80);  // reads delta_buf at current DELTA_IDX (cell=1, row=3)
        if (wb_rdat[7:0] == 8'hAB) `PASS("T4-readback: delta_flat[1,3] via WB")
        else begin
            $display("  FAIL T4-readback: got %02h", wb_rdat[7:0]);
            fail_cnt = fail_cnt + 1;
        end

        // ── T5: EMX_CTRL[0] → start_e_update pulse ───────────────────────
        wb_write(32'h84, 32'h1);  // start_e_update
        @(posedge clk); #1;
        // start_e_update is a one-cycle pulse; check it fired this cycle
        // (it was set in the same cycle the WB write executed)
        // We need to capture it — check it on the same posedge as the write
        // Actually: the write sets start_e_update=1 during posedge clk, then
        // the default deassert fires on the next posedge.
        // So: after wb_write returns (1 cycle later), pulse already fired.
        // Just verify it deasserts:
        if (!start_e_update) `PASS("T5-pulse: start_e_update deasserted after 1 cycle")
        else `FAIL("T5-pulse: start_e_update still asserted")

        // ── T6: EMX_CTRL[1] → start_absorb pulse ─────────────────────────
        wb_write(32'h84, 32'h2);
        @(posedge clk); #1;
        if (!start_absorb) `PASS("T6-pulse: start_absorb deasserted")
        else `FAIL("T6-pulse: start_absorb still asserted")

        // ── T7: EMX_CTRL[2] → start_save pulse ───────────────────────────
        wb_write(32'h84, 32'h4);
        @(posedge clk); #1;
        if (!start_save) `PASS("T7-pulse: start_save deasserted")
        else `FAIL("T7-pulse: start_save still asserted")

        // ── T8: EMX_STATUS reflects busy inputs ───────────────────────────
        e_update_busy=1; absorb_busy=1; save_busy=1;
        @(posedge clk); #1;
        wb_read(32'h88);
        if (wb_rdat[2:0] == 3'b111) `PASS("T8-busy: STATUS=0b111 when all busy")
        else begin
            $display("  FAIL T8-busy: STATUS=%03b", wb_rdat[2:0]);
            fail_cnt = fail_cnt + 1;
        end
        e_update_busy=0; absorb_busy=0; save_busy=0;
        wb_read(32'h88);
        if (wb_rdat[2:0] == 3'b000) `PASS("T8-idle: STATUS=0b000 when all idle")
        else begin
            $display("  FAIL T8-idle: STATUS=%03b", wb_rdat[2:0]);
            fail_cnt = fail_cnt + 1;
        end

        // ── T9: REFRESH_EN ────────────────────────────────────────────────
        wb_write(32'h8C, 32'h1);
        @(posedge clk); #1;
        if (refresh_en == 1'b1) `PASS("T9-write: refresh_en=1")
        else `FAIL("T9-write: refresh_en not set")
        wb_read(32'h8C);
        if (wb_rdat[0] == 1'b1) `PASS("T9-read: refresh_en readback=1")
        else `FAIL("T9-read: refresh_en readback wrong")

        // ── T10: Inherited register — HEBB_PW at 0x14 ────────────────────
        wb_write(32'h14, 32'd5000);  // HEBB_PW
        @(posedge clk); #1;
        wb_read(32'h14);
        if (wb_rdat[15:0] == 16'd5000) `PASS("T10-inherited: HEBB_PW=5000")
        else begin
            $display("  FAIL T10-inherited: HEBB_PW=%0d", wb_rdat[15:0]);
            fail_cnt = fail_cnt + 1;
        end

        $display("\n=== Results: %0d passed, %0d failed ===",
                 pass_cnt, fail_cnt);
        if (fail_cnt == 0) $display("ALL PASS");
        else               $display("FAILURES DETECTED");
        $finish;
    end

    initial begin
        #100000; $display("TIMEOUT"); $finish;
    end

endmodule
